enwi/ESP8266_breakout/README.md

# edgy_board number b123
This design is part of the [edgy board project](https://github.com/skunkforce/edgy_boards). It provides the functionality of chip XXXX via interfaces YYYY. 



# getting started
This repository uses submodules. After cloning use the command 

```$ git submodule update --init --recursive```

to pull the submodules before opening the project with kicad. 

# Tests
Tests can be found in [TESTS.md](TESTS.md)
